Zubax/Opencopcho/production/BOM.xlsx

Sheet: BOM
Qty | Value | Device | Package | Parts | Description | COLOR | DIGIKEY# | IF | MANF | MANF#
4 |  | DB9-M | D-09M | CON1, CON2, CON3, CON4 |  |  | AE10973-ND |  | Assmann WSW Components | A-DS 09 PP/Z
2 | 0.1µF | 0.1µF-16V_10%_X7R-0603 | C0603 | C1, C2 |  |  | 490-1532-1-ND |  | Murata Electronics North America | GRM188R71C104KA01D
2 | 10R | R-5%-0805 | R0805 | R1, R3 |  |  | RNCP0805FTD10R0CT-ND
2 | 120R | R-1%-0805 | R0805 | R2, R40 |  |  | RHM120KCT-ND
2 | 470R | R-5%-0805 | R0805 | R4, R10 |  |  | P470ACT-ND
4 | CON-4P-JST_GH-RA | CON-4P-JST_GH-RA | JST_GH-4P-RA | CON5, CON6, CON12, CON13 | Connector Receptacle 4 Position 0.049 (1.25mm) Tin Surface Mount" |  | 455-1566-1-ND |  | JST Sales America Inc | SM04B-GHS-TB(LF)(SN)
1 | GW1584_MODULE | GW1584_MODULE | GW1584_MODULE | MODULE2 | THIS http://mysku.ru/blog/aliexpress/35938.html
2 | LED-0805 | LED-0805 | LED0805 | LED1, LED2 | SMD LED | GREEN | 160-1413-1-ND
2 | MCP2542WFD | MCP2542WFD | SOIC8-3.9 | IC2, IC6 | 1/1 Transceiver CANbus 8-SOIC |  | MCP2542WFD-H/SN-ND |  | Microchip Technology | MCP2542WFD-H/SN
2 | PINHEAD_1X02-2.54 | PINHEAD_1X02-2.54 | 1X02-PTH-2.54 | CON7, CON14 | pinheader 2P
4 | PINHEAD_1X05-2.54-KEY | PINHEAD_1X05-2.54-KEY | 1X05-PTH-2.54-KEY | CON10, CON11, CON15, CON16 | pinheader 5P |  | S9413-ND |  | Sullins Connector Solutions | SWR25X-NRTC-S05-ST-BA
1 | PINHEAD_2X08-TH-FEMALE-LONG | PINHEAD_2X08-TH-FEMALE-LONG | 2X08-PTH-2.54-FEMALE-LONG-PINS | CON19 |  |  | SAM10008-ND |  | Samtec Inc | SSQ-108-23-G-D
1 | PINHEAD_2X10-2.54-TH-FEMALE-LONG | PINHEAD_2X10-2.54-TH-FEMALE-LONG | 2X10-PTH-2.54-FEMALE-LONG-PINS | CON20 | 20 Position Receptacle Connector 0.079 (2.00mm) Surface Mount Gold" |  | SAM10741-ND |  | Samtec Inc | SSQ-110-23-G-D
1 | PINHEAD_2X15-2.54-FEMALE-LONG | PINHEAD_2X15-2.54-FEMALE-LONG | 2X15-PTH-2.54-FEMALE-LONG-PINS | CON18 |  |  | SAM1204-15-ND |  | Samtec Inc | SSQ-115-03-T-D
1 | PINHEAD_2X17-TH-FEMALE-LONG | PINHEAD_2X17-TH-FEMALE-LONG | 2X17-PTH-2.54-FEMALE-LONG_PINS | CON17 |  |  | SAM1196-17-ND |  | Samtec Inc | SSQ-117-03-G-D
4 | PMEG4020 | PMEG4020 | SOD123W | D3, D5, D7, D8 | DIODE SCHOTTKY 40V 2A SOD123W |  | 1727-5385-2-ND | 2A | NXP Semiconductors | PMEG4020ER,115
2 | SM712 | SM712 | SOT23B-3 | D2, D21 | TVS DIODE 12VWM/7VWM SOT23 |  | SM712-TPMSCT-ND |  | Semtech Corporation | SM712.TCT
2 | SMBJ24CA-SMB | SMBJ24CA-SMB | DO-214AA(SMB) | D4, D6 | TVS DIODE 24V 38.9V DO214AA |  | SMBJ24CA-TPMSCT-ND |  | Micro Commercial Co | SMBJ24CA-TP
1 | SMBJ5.0CA-SMB | SMBJ5.0CA-SMB | DO-214AA(SMB) | D9 | TVS DIODE 51VWM SMD |  | SMBJ5.0CABTR-ND |  | Bourns Inc | SMBJ5.0CA
Exclude from digikey order

Sheet: digikey_order
Qty@1pcb | Qty@N pcb | Value | Device | Package | Parts | Description | COLOR | DIGIKEY# | IF | MANF | MANF#
4 | 40 |  | DB9-M | D-09M | CON1, CON2, CON3, CON4 |  |  | AE10973-ND |  | Assmann WSW Components | A-DS 09 PP/Z
2 | 20 | 0.1µF | 0.1µF-16V_10%_X7R-0603 | C0603 | C1, C2 |  |  | 490-1532-1-ND |  | Murata Electronics North America | GRM188R71C104KA01D
2 | 20 | 10R | R-5%-0805 | R0805 | R1, R3 |  |  | RNCP0805FTD10R0CT-ND
2 | 20 | 120R | R-1%-0805 | R0805 | R2, R40 |  |  | RHM120KCT-ND
2 | 20 | 470R | R-5%-0805 | R0805 | R4, R10 |  |  | P470ACT-ND
4 | 40 | CON-4P-JST_GH-RA | CON-4P-JST_GH-RA | JST_GH-4P-RA | CON5, CON6, CON12, CON13 | Connector Receptacle 4 Position 0.049 (1.25mm) Tin Surface Mount" |  | 455-1566-1-ND |  | JST Sales America Inc | SM04B-GHS-TB(LF)(SN)
2 | 20 | LED-0805 | LED-0805 | LED0805 | LED1, LED2 | SMD LED | ORANGE | 160-1413-1-ND
2 | 20 | MCP2542WFD | MCP2542WFD | SOIC8-3.9 | IC2, IC6 | 1/1 Transceiver CANbus 8-SOIC |  | MCP2542WFD-H/SN-ND |  | Microchip Technology | MCP2542WFD-H/SN
4 | 40 | PINHEAD_1X05-2.54-KEY | PINHEAD_1X05-2.54-KEY | 1X05-PTH-2.54-KEY | CON10, CON11, CON15, CON16 | pinheader 5P |  | S9413-ND |  | Sullins Connector Solutions | SWR25X-NRTC-S05-ST-BA
1 | 10 | PINHEAD_2X08-TH-FEMALE-LONG | PINHEAD_2X08-TH-FEMALE-LONG | 2X08-PTH-2.54-FEMALE-LONG-PINS | CON19 |  |  | SAM10008-ND |  | Samtec Inc | SSQ-108-23-G-D
1 | 10 | PINHEAD_2X10-2.54-TH-FEMALE-LONG | PINHEAD_2X10-2.54-TH-FEMALE-LONG | 2X10-PTH-2.54-FEMALE-LONG-PINS | CON20 | 20 Position Receptacle Connector 0.079 (2.00mm) Surface Mount Gold" |  | SAM10741-ND |  | Samtec Inc | SSQ-110-23-G-D
1 | 10 | PINHEAD_2X15-2.54-FEMALE-LONG | PINHEAD_2X15-2.54-FEMALE-LONG | 2X15-PTH-2.54-FEMALE-LONG-PINS | CON18 |  |  | SAM1204-15-ND |  | Samtec Inc | SSQ-115-03-T-D
1 | 10 | PINHEAD_2X17-TH-FEMALE-LONG | PINHEAD_2X17-TH-FEMALE-LONG | 2X17-PTH-2.54-FEMALE-LONG_PINS | CON17 |  |  | SAM1196-17-ND |  | Samtec Inc | SSQ-117-03-G-D
4 | 40 | PMEG4020 | PMEG4020 | SOD123W | D3, D5, D7, D8 | DIODE SCHOTTKY 40V 2A SOD123W |  | 1727-5385-2-ND | 2A | NXP Semiconductors | PMEG4020ER,115
2 | 20 | SM712 | SM712 | SOT23B-3 | D2, D21 | TVS DIODE 12VWM/7VWM SOT23 |  | SM712-TPMSCT-ND |  | Semtech Corporation | SM712.TCT
2 | 20 | SMBJ24CA-SMB | SMBJ24CA-SMB | DO-214AA(SMB) | D4, D6 | TVS DIODE 24V 38.9V DO214AA |  | SMBJ24CA-TPMSCT-ND |  | Micro Commercial Co | SMBJ24CA-TP
1 | 10 | SMBJ5.0CA-SMB | SMBJ5.0CA-SMB | DO-214AA(SMB) | D9 | TVS DIODE 51VWM SMD |  | SMBJ5.0CABTR-ND |  | Bourns Inc | SMBJ5.0CA
N | 10
