Zubax/Opencopcho/production/bom_link.txt

https://docs.google.com/spreadsheets/d/1fQ1Vy-vu5_NFVYvdyqMBftGQwtiUAxBgpwAjI8aS_6I/edit?usp=sharing
