Zubax/Opencopcho/production/assembbly.pdf

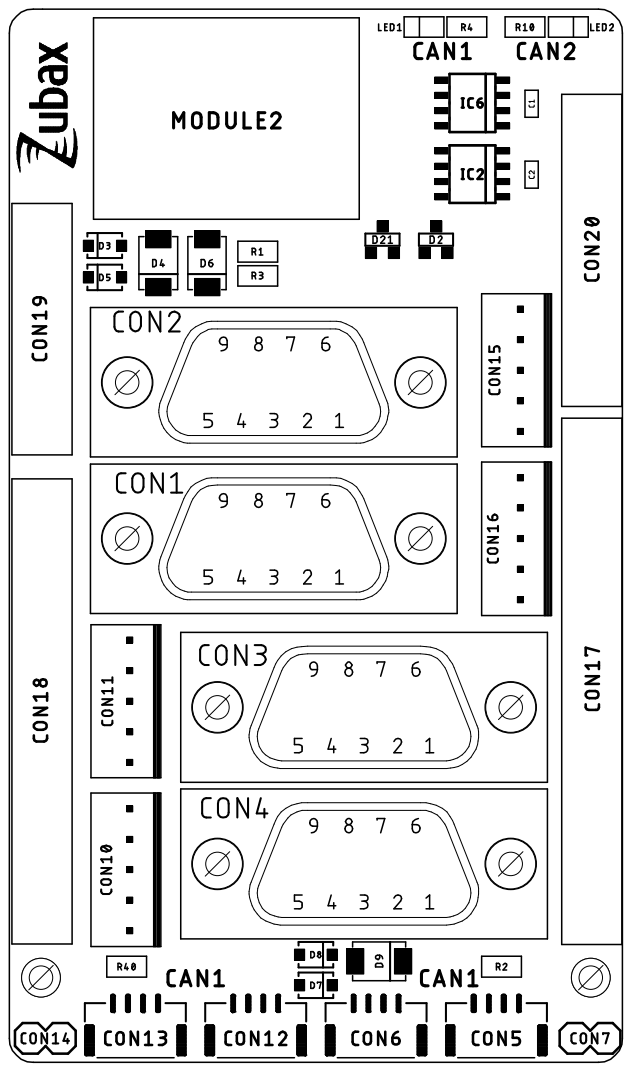
[picture p4: page 1]
