Zubax/Opencopcho/opencopcho.brd

## EAGLE design opencopcho.brd (2018-11-23)

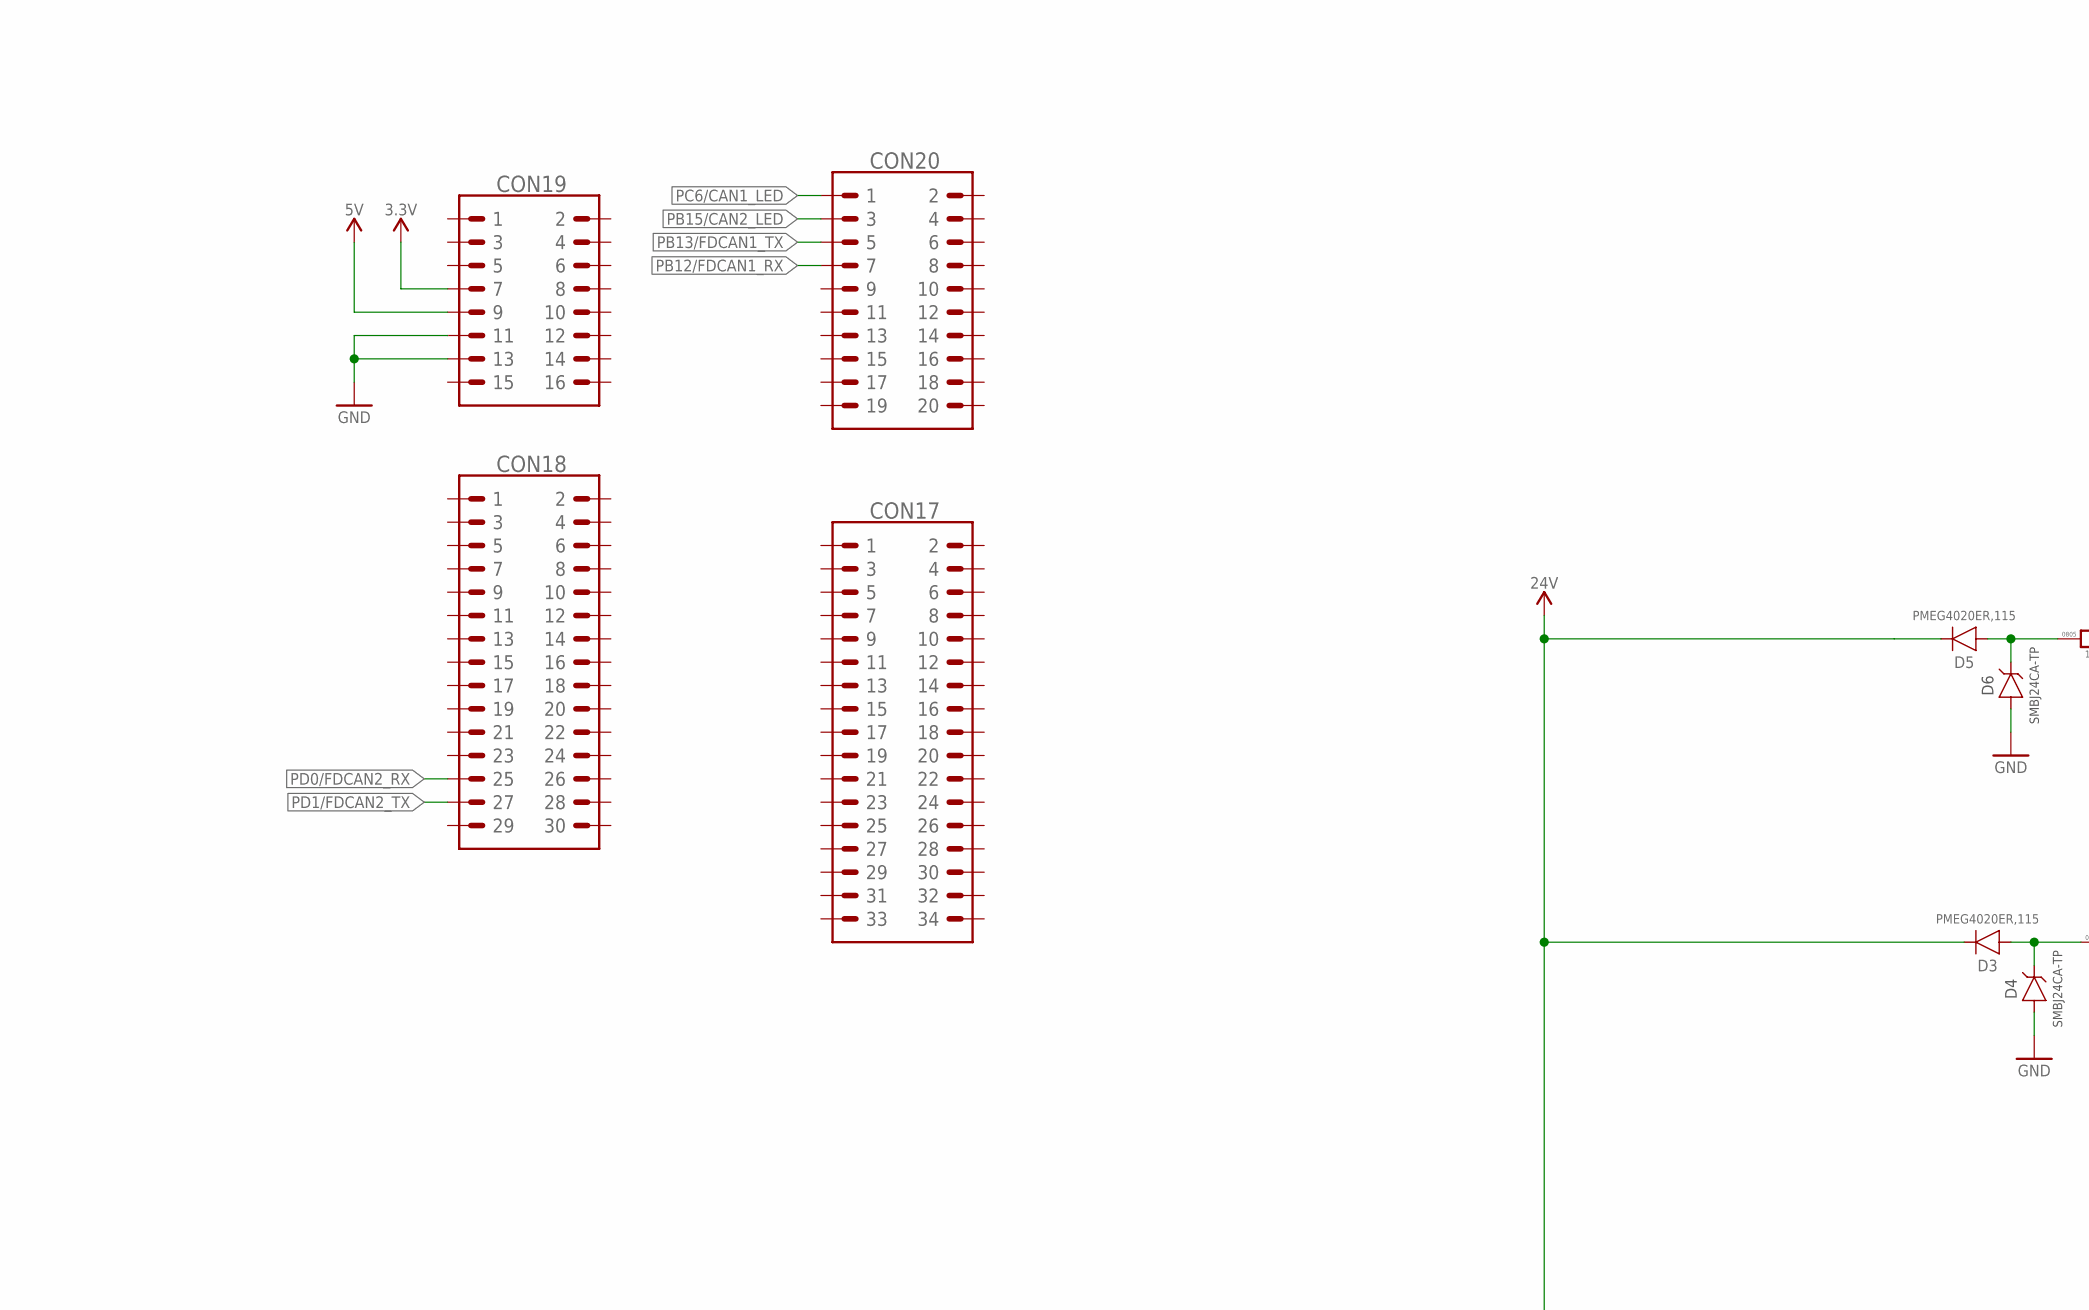
[picture p5: schematic opencopcho.sch, part in row 1, column 1]

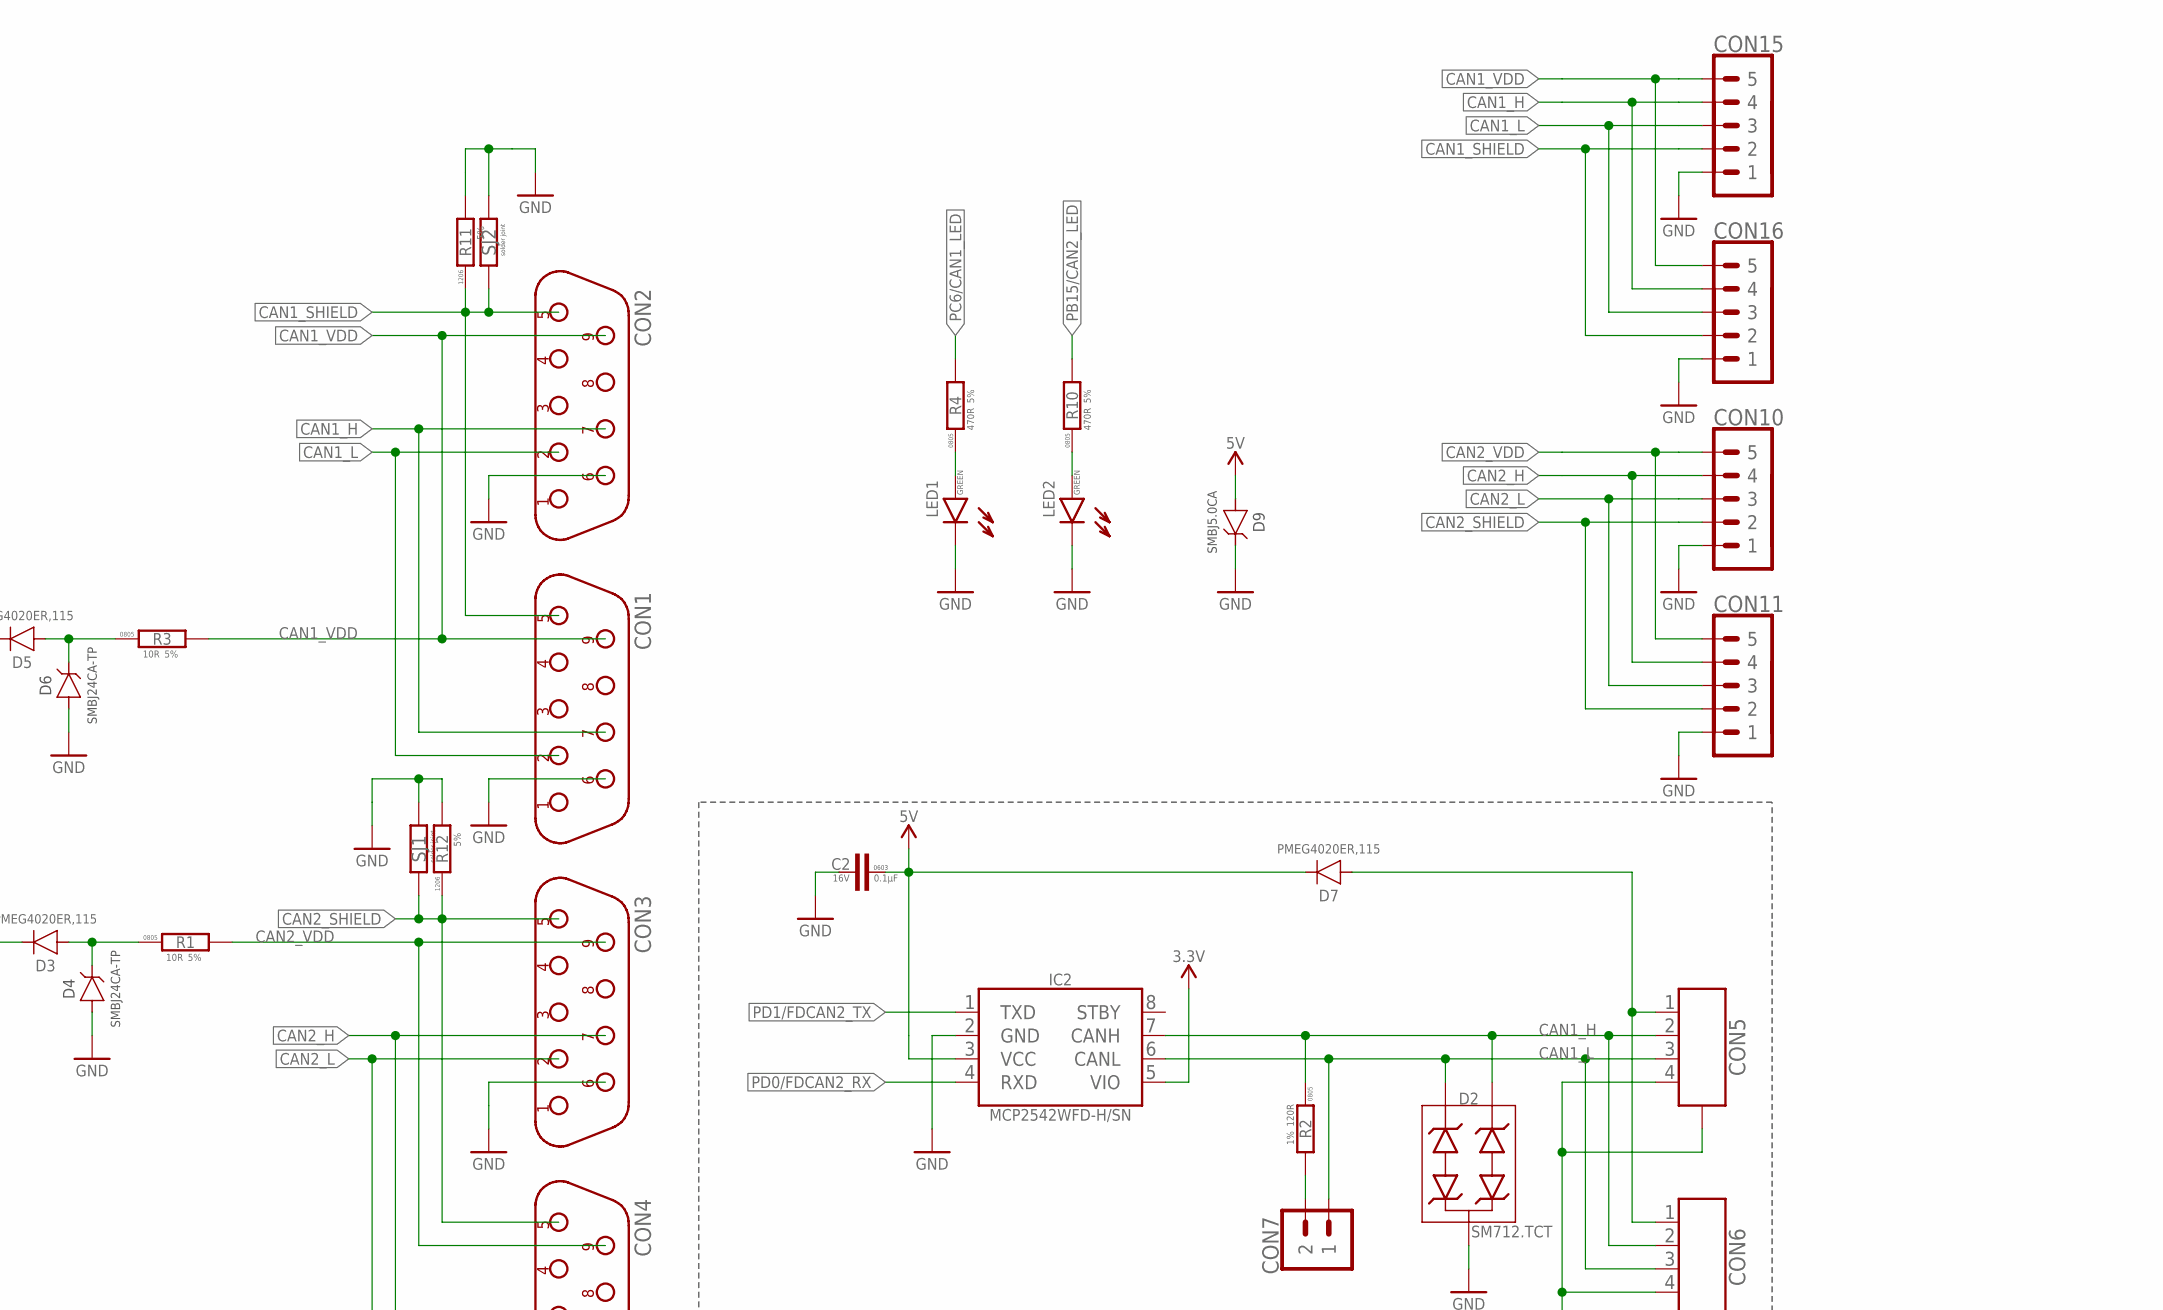
[picture p6: schematic opencopcho.sch, part in row 1, column 2]

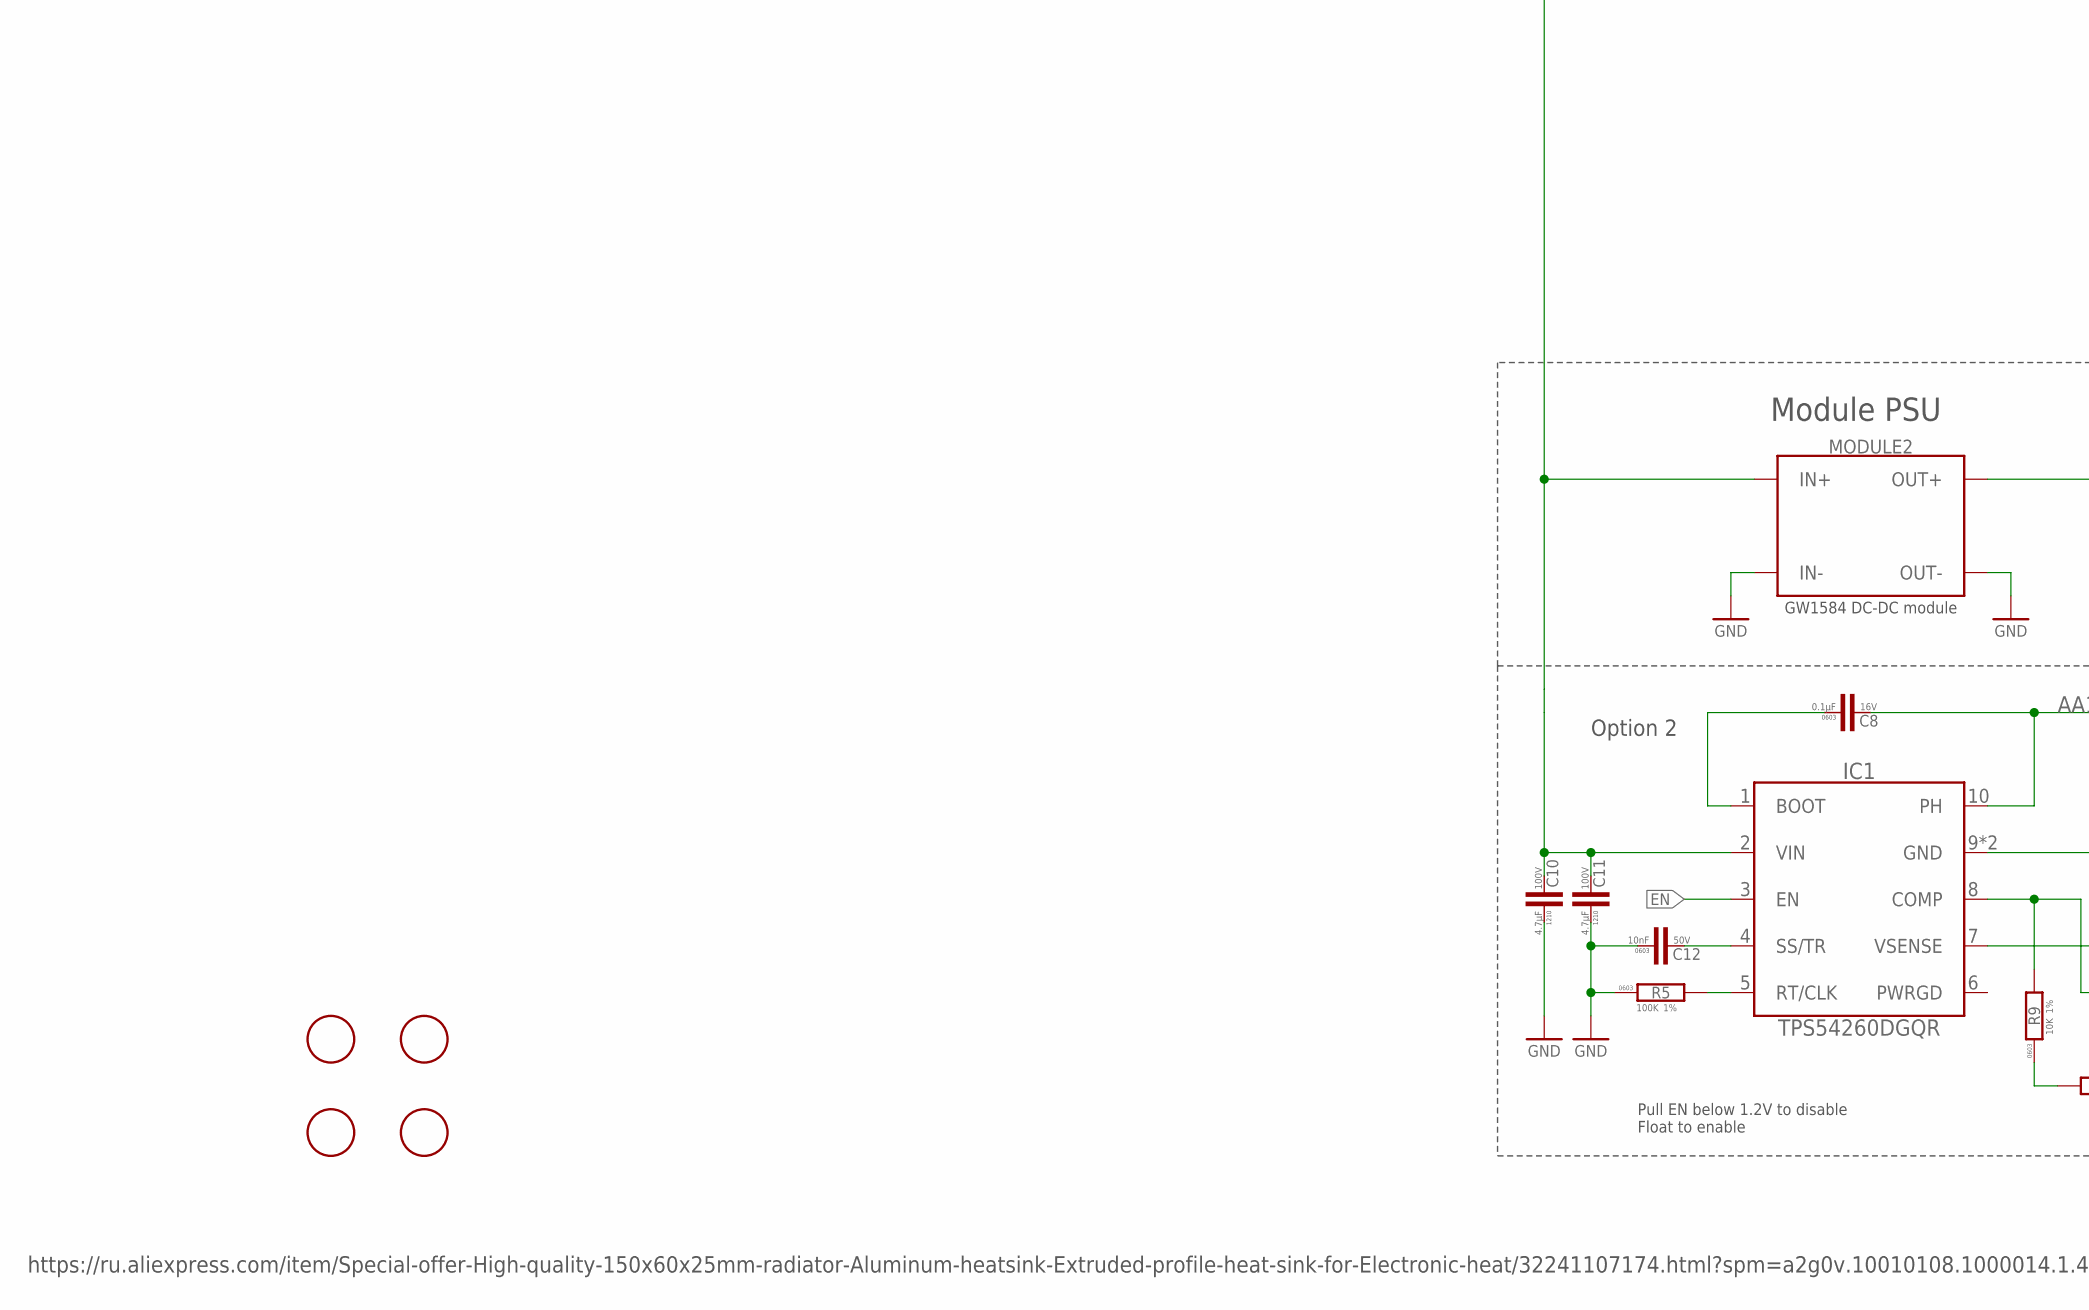
[picture p7: schematic opencopcho.sch, part in row 2, column 1]

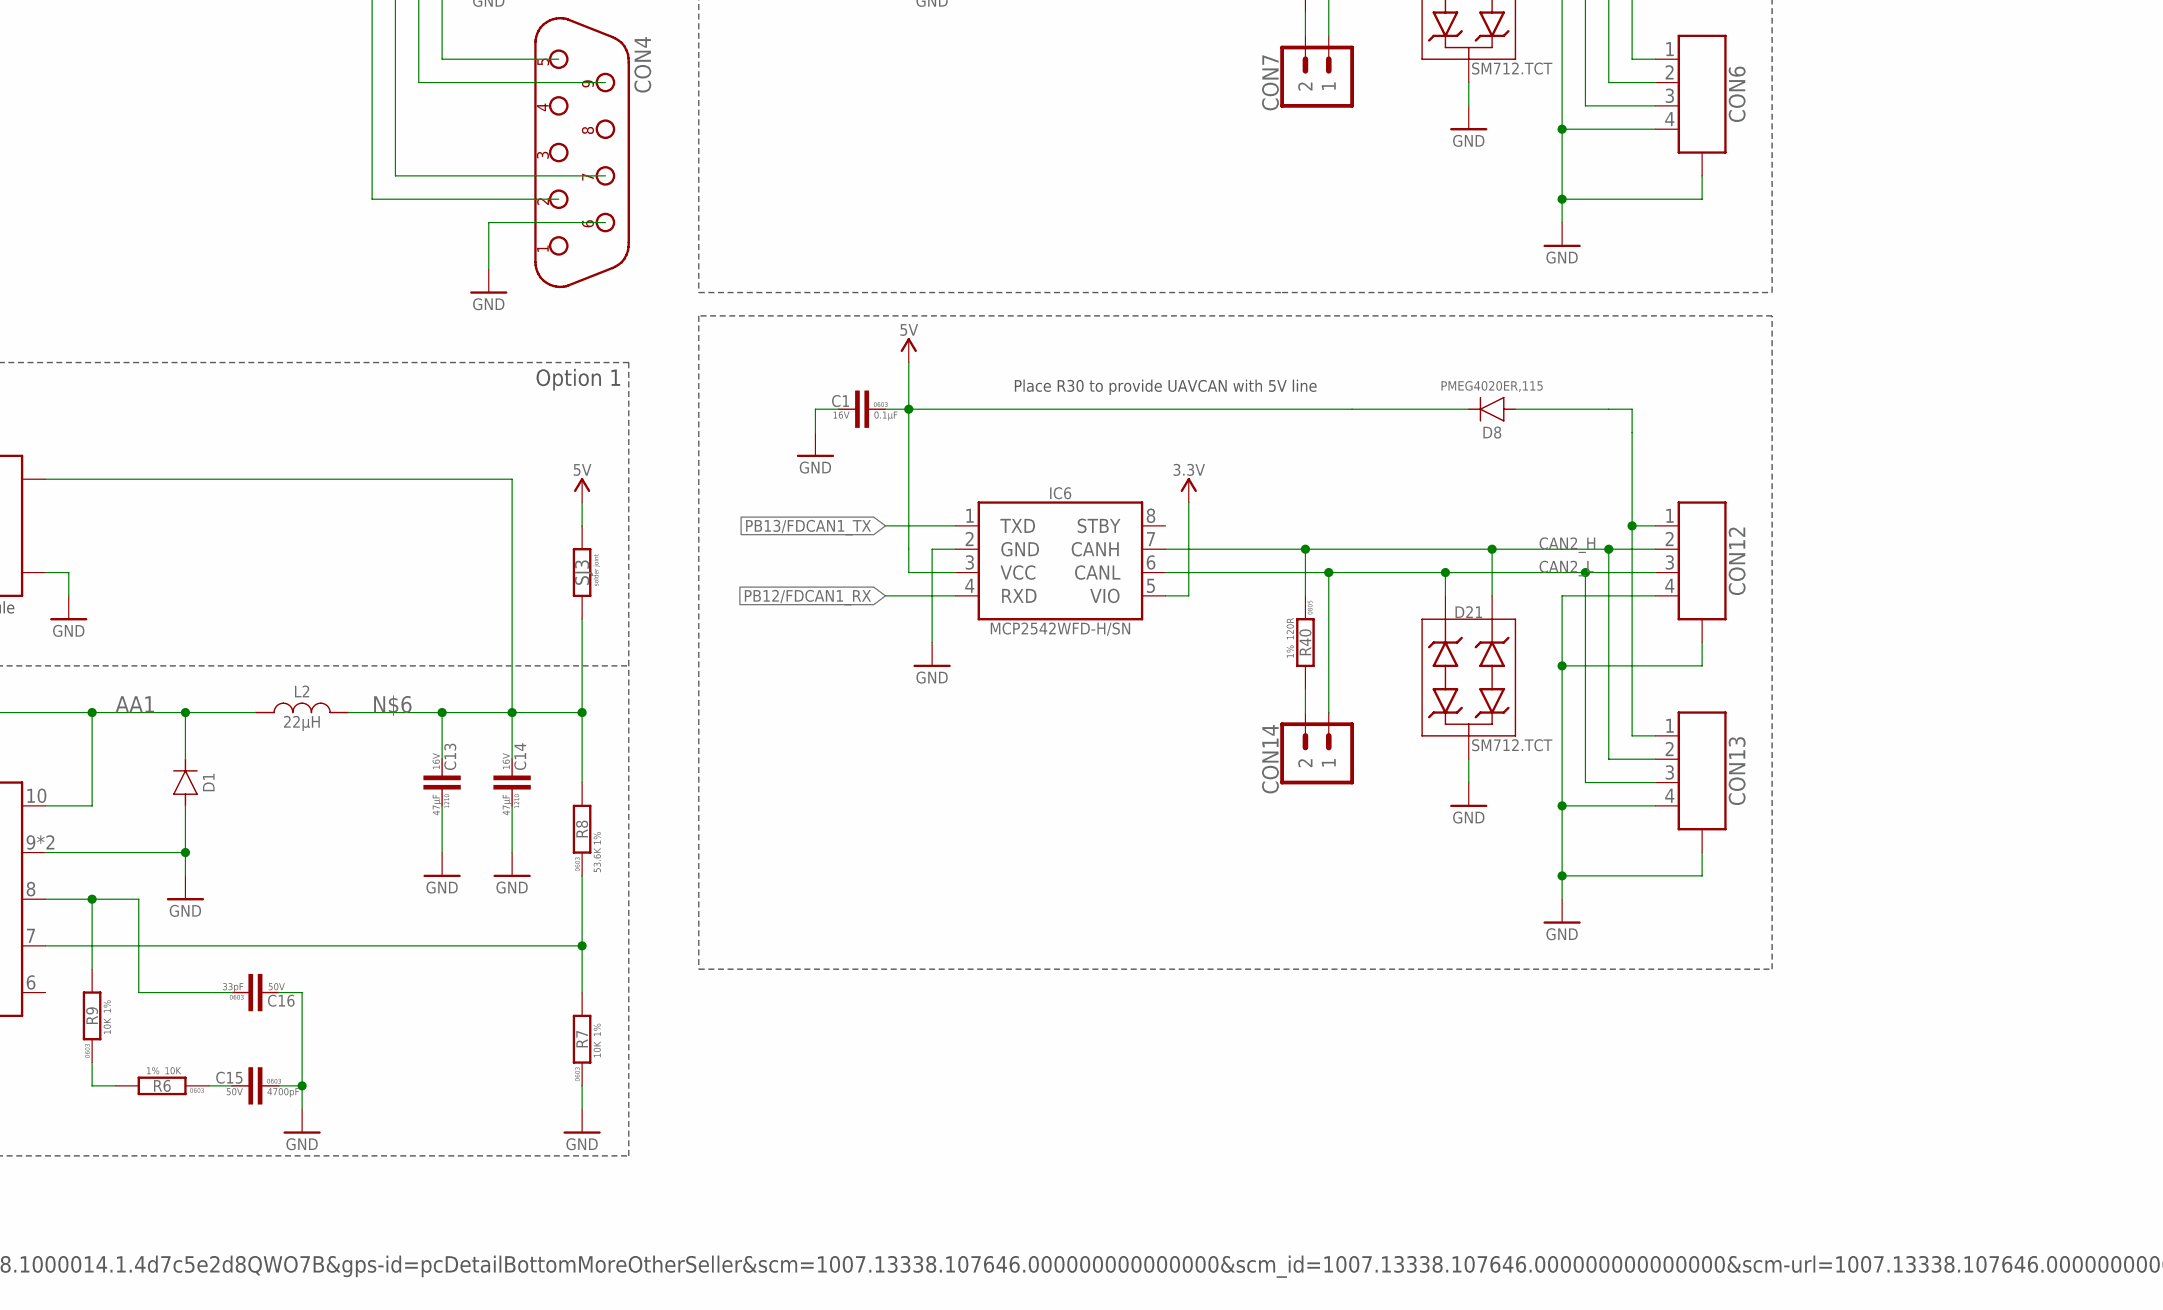
[picture p8: schematic opencopcho.sch, part in row 2, column 2]

Parts:
C1, C2, C8: 0.1µF; C0603
C10, C11: 4.7µF; C1210
C12: 10nF; C0603
C13, C14: 47µF; C1210
C15: 4700pF; C0603
C16: 33pF; C0603
CON1, CON2, CON3, CON4: DB9-M; D-09M
CON5, CON6, CON12, CON13: CON-4P-JST_GH-RA; JST_GH-4P-RA
CON7, CON14: PINHEAD_1X02-2.54; 1X02-PTH-2.54
CON10, CON11, CON15, CON16: PINHEAD_1X05-2.54-KEY; 1X05-PTH-2.54-KEY
CON17: PINHEAD_2X17-TH-FEMALE-LONG; 2X17-PTH-2.54-FEMALE-LONG_PINS
CON18: PINHEAD_2X15-2.54-FEMALE-LONG; 2X15-PTH-2.54-FEMALE-LONG-PINS
CON19: PINHEAD_2X08-TH-FEMALE-LONG; 2X08-PTH-2.54-FEMALE-LONG-PINS
CON20: PINHEAD_2X10-2.54-TH-FEMALE-LONG; 2X10-PTH-2.54-FEMALE-LONG-PINS
D1: B360B; DO-214AA(SMB); DIGIKEY# B360B-FDICT-ND
D2, D21: SM712; SOT23B-3
D3, D5, D7, D8: PMEG4020; SOD123W
D4, D6: SMBJ24CA-SMB; DO-214AA(SMB)
D9: SMBJ5.0CA-SMB; DO-214AA(SMB)
IC1: TPS54260; MSOP10
IC2, IC6: MCP2542WFD; SOIC8-3.9
L2: 22µH; SRP6540; DIGIKEY# SRP6540-4R7MCT-ND
LED1, LED2: LED-0805; LED0805
MODULE2: GW1584_MODULE
R1, R3: 10R; R0805
R2, R40: 120R; R0805
R4, R10: 470R; R0805
R5: 100K; R0603
R6, R7, R9: 10K; R0603
R8: 53.6K 1%; R0603; DIGIKEY# 311-53.6KHRCT-ND
R11, R12: R-5%-1206; R1206
SJ1, SJ2, SJ3: SOLDER_JOINT; RES_0
U$5, U$6, U$7, U$11: FIDUCIALMOUNT; FIDUCIA-MOUNT

Connections:
AA1: C8.P$2 (2), D1.C, IC1.10 (PH), L2.1
CAN1_H: CON1.7, CON2.7, CON5.2, CON6.2, CON15.4, CON16.4, D2.1 (C3), IC2.7 (CANH), R2.1
CAN1_L: CON1.2, CON2.2, CON5.3, CON6.3, CON7.1, CON15.3, CON16.3, D2.2 (C2), IC2.6 (CANL)
CAN1_SHIELD: CON1.5, CON2.5, CON15.2, CON16.2, R11.P$1 (1), SJ2.1
CAN1_VDD: CON1.9, CON2.9, CON15.5, CON16.5, R3.2
CAN2_H: CON3.7, CON4.7, CON10.4, CON11.4, CON12.2, CON13.2, D21.1 (C3), IC6.7 (CANH), R40.1
CAN2_L: CON3.2, CON4.2, CON10.3, CON11.3, CON12.3, CON13.3, CON14.1, D21.2 (C2), IC6.6 (CANL)
CAN2_SHIELD: CON3.5, CON4.5, CON10.2, CON11.2, R12.P$1 (1), SJ1.1
CAN2_VDD: CON3.9, CON4.9, CON10.5, CON11.5, R1.2
EN: IC1.3 (EN)
FB1: IC1.7 (VSENSE), R7.P$2 (2), R8.1
GND: C1.P$2 (2), C2.P$2 (2), C10.1, C11.1, C12.P$1 (1), C13.1, C14.1, C15.P$1 (1), C16.P$2 (2), CON1.6, CON2.6, CON3.6, CON4.6, CON5.4, CON5.M$0 (GND), CON5.M$1 (GND), CON6.4, CON6.M$0 (GND), CON6.M$1 (GND), CON10.1, CON11.1, CON12.4, CON12.M$0 (GND), CON12.M$1 (GND), CON13.4, CON13.M$0 (GND), CON13.M$1 (GND), CON15.1, CON16.1, CON19.11, CON19.13, D1.A, D2.3, D4.A, D6.A, D9.C, D21.3, IC1.9 (GND), IC1.TPAD (GND), IC2.2 (GND), IC6.2 (GND), LED1.C, LED2.C, MODULE2.IN-@1 (IN-), MODULE2.IN-@2 (IN-), MODULE2.OUT-@1 (OUT-), MODULE2.OUT-@2 (OUT-), R5.P$1 (1), R7.P$1 (1), R11.P$2 (2), R12.P$2 (2), SJ1.2, SJ2.2
unnamed: C8.P$1 (1), IC1.1 (BOOT)
unnamed: LED1.A, R4.1
unnamed: CON12.1, CON13.1, D8.A
unnamed: C12.P$2 (2), IC1.4 (SS/TR)
unnamed: CON7.2, R2.2
unnamed: C13.2, C14.2, L2.2, MODULE2.OUT+@1 (OUT+), MODULE2.OUT+@2 (OUT+), R8.2, SJ3.1
unnamed: LED2.A, R10.1
unnamed: CON5.1, CON6.1, D7.A
unnamed: IC1.5 (RT/CLK), R5.P$2 (2)
unnamed: C16.P$1 (1), IC1.8 (COMP), R9.P$2 (2)
unnamed: C15.P$2 (2), R6.P$1 (1)
unnamed: R6.P$2 (2), R9.P$1 (1)
unnamed: D5.A, D6.C, R3.1
unnamed: D3.A, D4.C, R1.1
unnamed: CON14.2, R40.2
PB12/FDCAN1_RX: CON20.7, IC6.4 (RXD)
PB13/FDCAN1_TX: CON20.5, IC6.1 (TXD)
PB15/CAN2_LED: CON20.3, R10.2
PC6/CAN1_LED: CON20.1, R4.2
PD0/FDCAN2_RX: CON18.25, IC2.4 (RXD)
PD1/FDCAN2_TX: CON18.27, IC2.1 (TXD)
VDD_3V3: CON19.7, IC2.5 (VIO), IC6.5 (VIO)
VDD_5V: C1.P$1 (1), C2.P$1 (1), CON19.9, D7.C, D8.C, D9.A, IC2.3 (VCC), IC6.3 (VCC), SJ3.2
VDD_24V: C10.2, C11.2, D3.C, D5.C, IC1.2 (VIN), MODULE2.IN+@1 (IN+), MODULE2.IN+@2 (IN+)

Notes on the sheet:
Pull EN below 1.2V to disable Float to enable
Module PSU
Option 1
Option 2
Place R30 to provide UAVCAN with 5V line
https://ru.aliexpress.com/item/Special-offer-High-quality-150x60x25mm-radiator-Aluminum-heatsink-Extruded-profile-heat-sink-for-Electronic-heat/32241107174.html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…

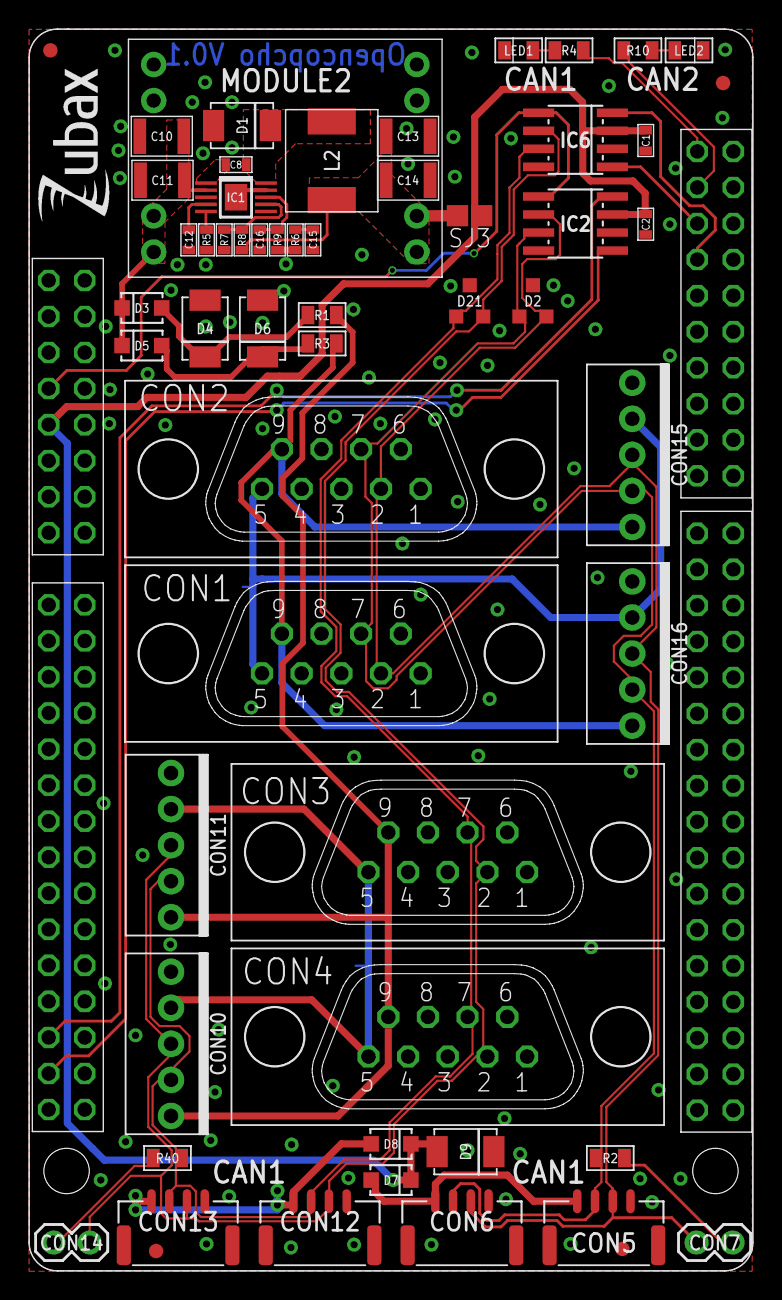
[picture p9: board opencopcho.brd from above]

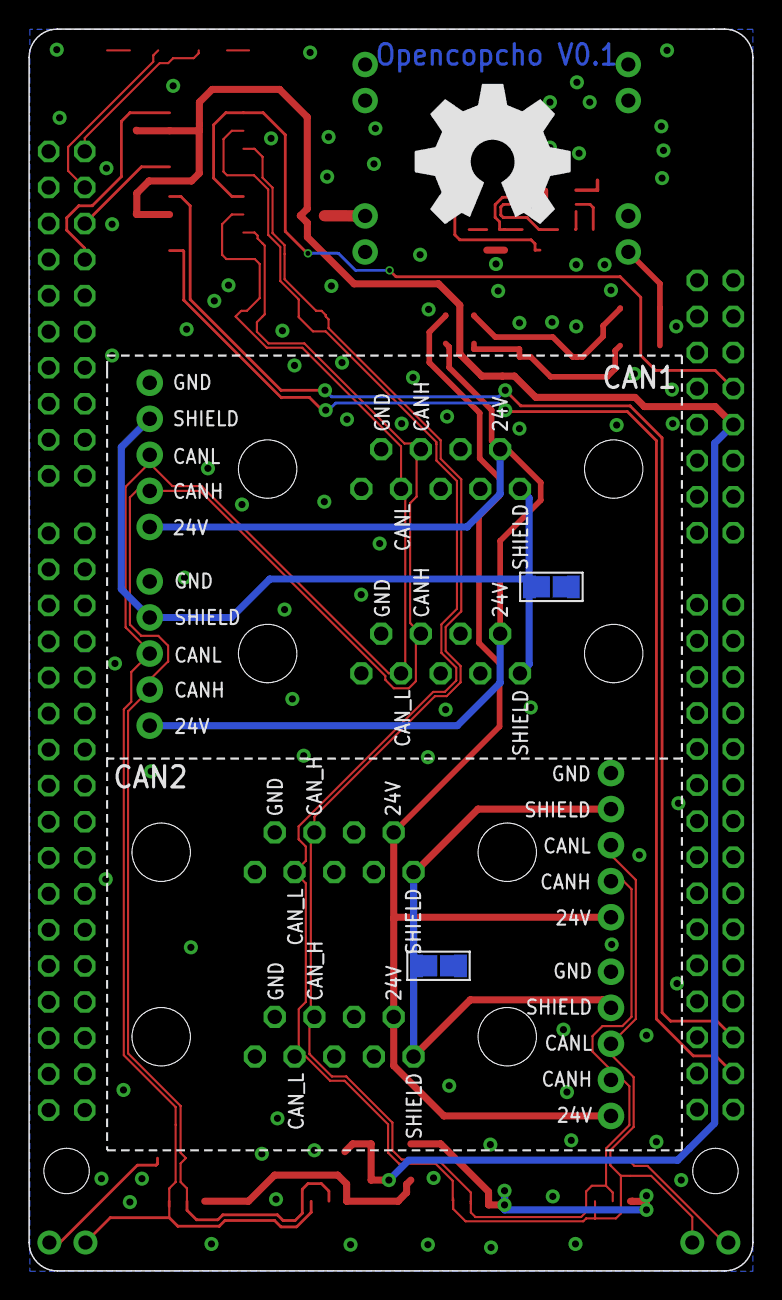
[picture p10: board opencopcho.brd from below]

Board: 2 copper layers, 51.0 x 87.5 mm, 67 parts (5 on the bottom side), 35 nets.

Other parts of the board:
U$1: ZUBAX_LOGO_5X10
U$4: OSHW-10.5X11.5
