Zubax/Opencopcho/(commit log)

2018-11-19 initial import
    [opencopcho.brd, opencopcho.sch]
2018-11-20 some updates
    [opencopcho.brd, opencopcho.sch]
2018-11-22 opencopcho is basically done
    [opencopcho.brd, opencopcho.sch]
2018-11-23 basic assembly variant
    [opencopcho.sch]
2018-11-23 temporary BOM link
    [opencopcho.brd, opencopcho.sch]
2018-11-23 silk updates
    [opencopcho.brd, opencopcho.sch]
2018-11-23 production docs update
    [BOM.xlsx]
